W4KRL/SolarPowerMonitor/Photo_Gallery.md

# Project Photo Gallery

## Bench View
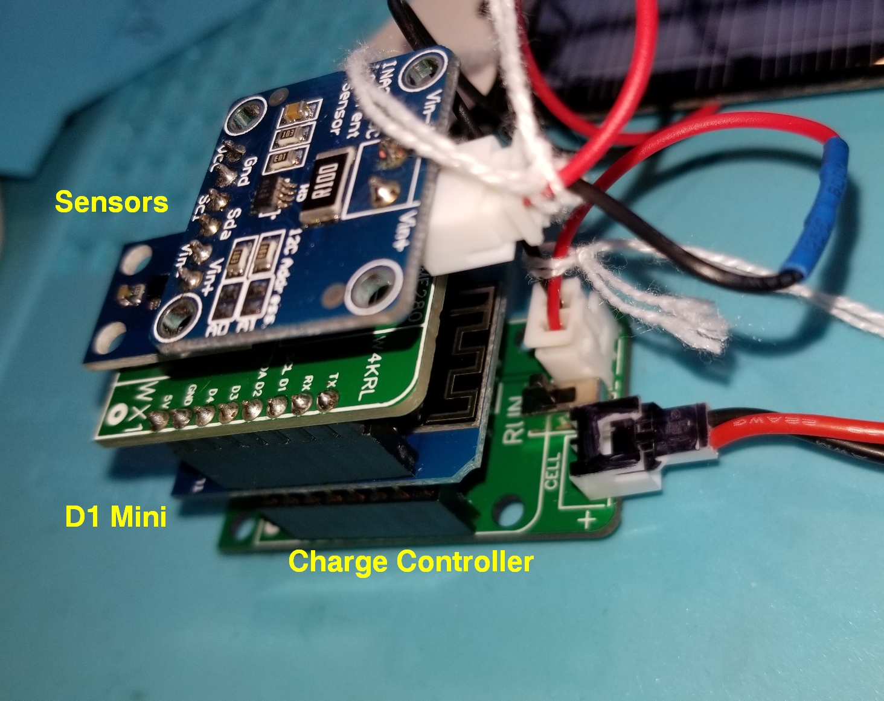
[picture p7: images/Bench_view.jpg]


### Side View with shields separated
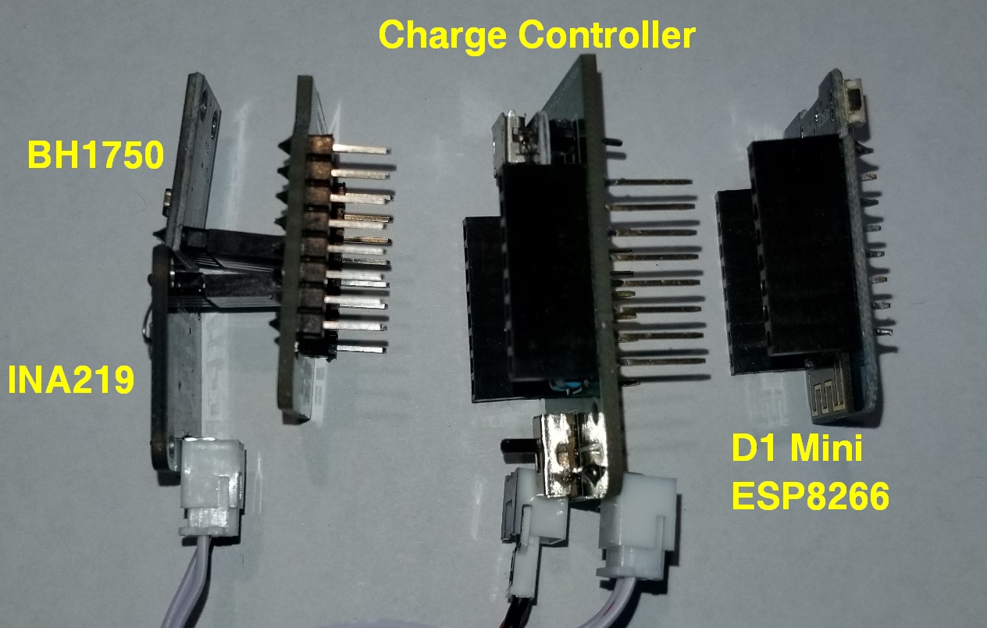
[picture p8: images/Exploded_Side_view_right.jpg]


### Top View with shields separated
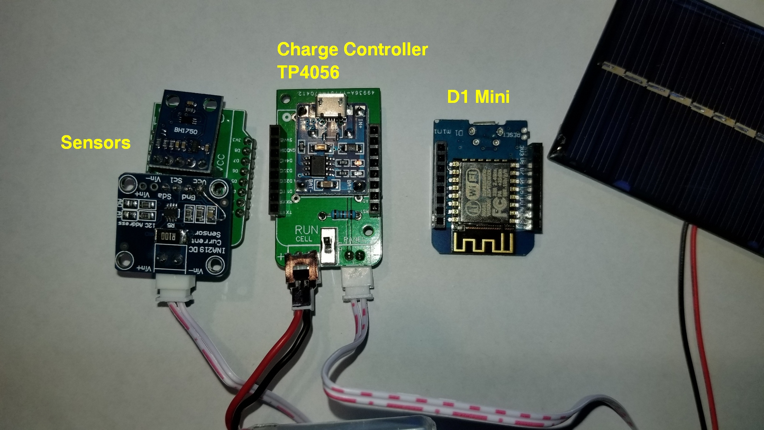
[picture p9: images/Top_view.jpg]


### Side View of assembled unit
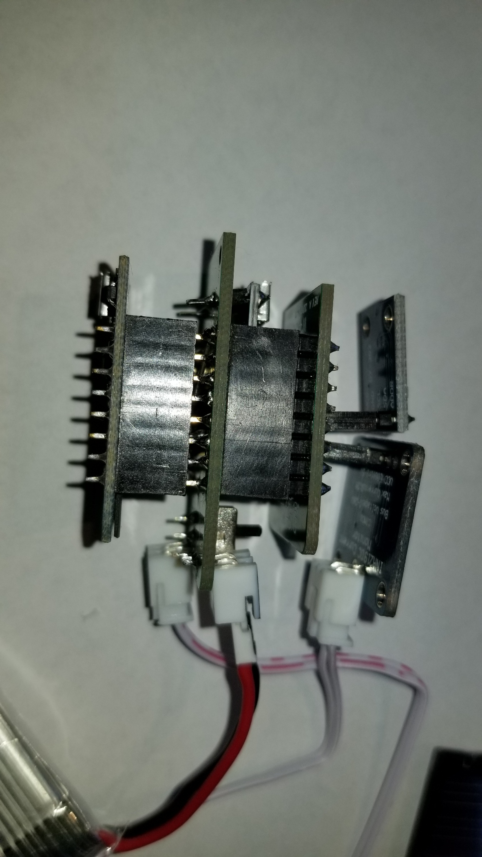
[picture p10: images/Assembled_side_view.jpg]


### Modification to charger board
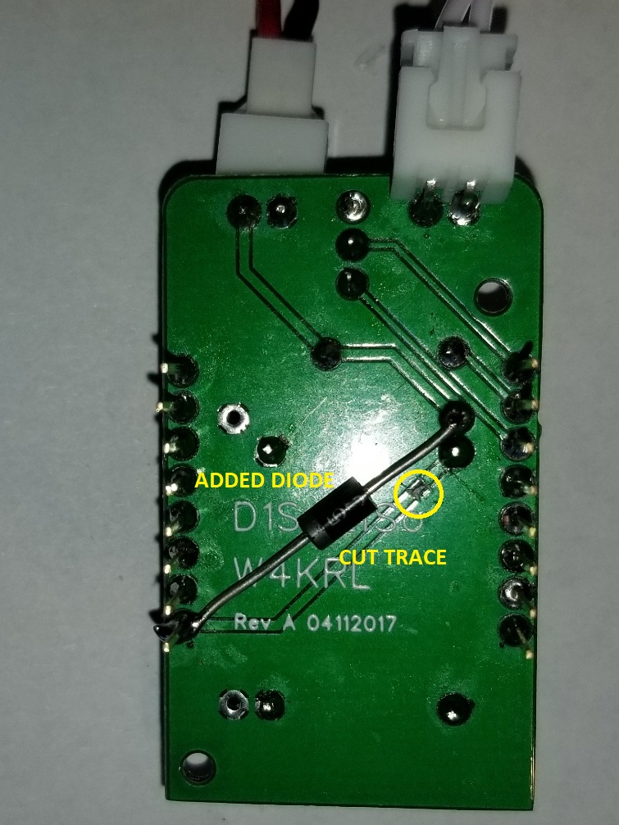
[picture p11: images/Charger_modification.jpg]


### Installation
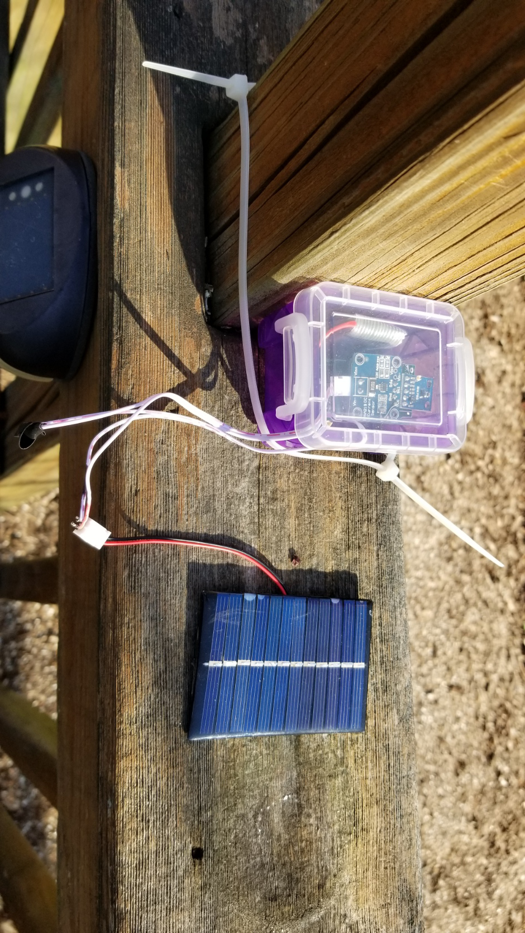
[picture p12: images/Installation.jpg]


### Unit in the rain
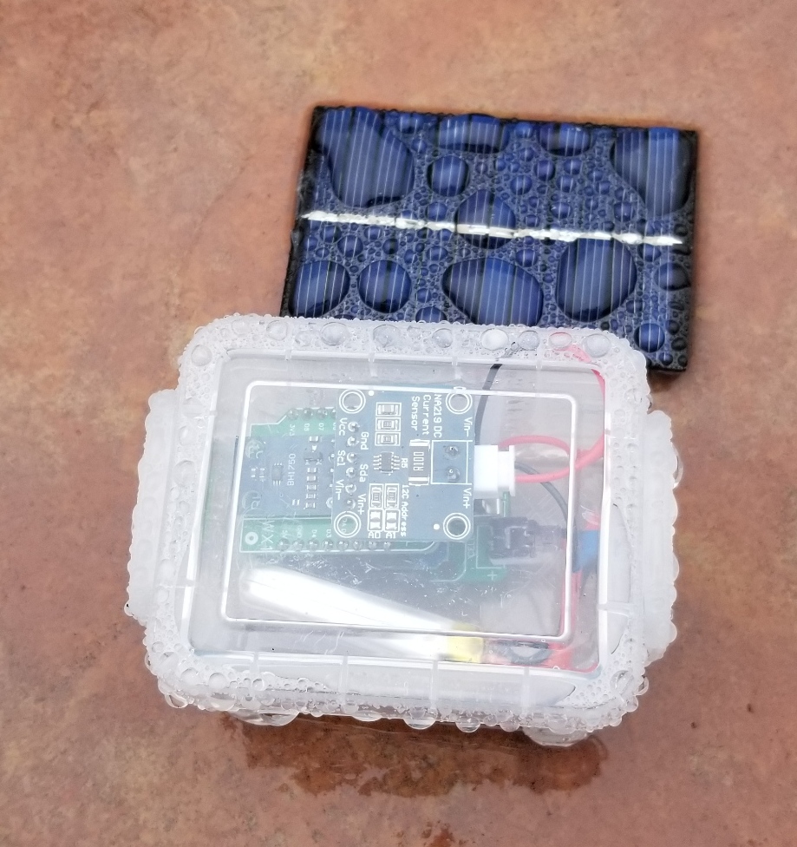
[picture p13: images/Unit-in-rain.jpg]


### Unit reconfigured to use a tripler base
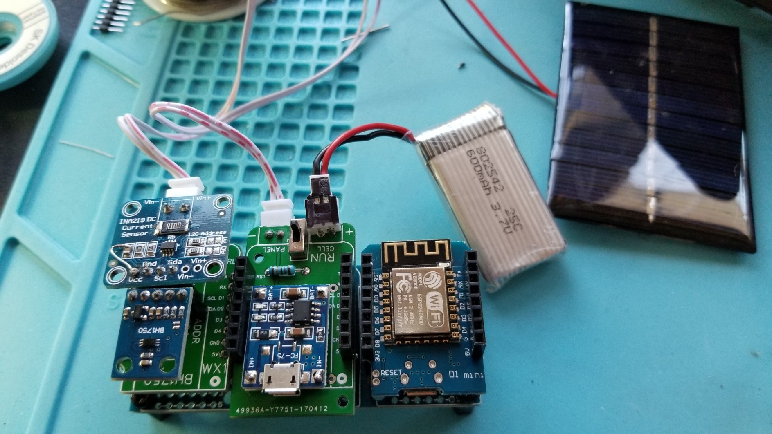
[picture p14: images/Tripler_top_view.jpg]


### Self-contained version with tripler base & solar panel mounted inside crayon box
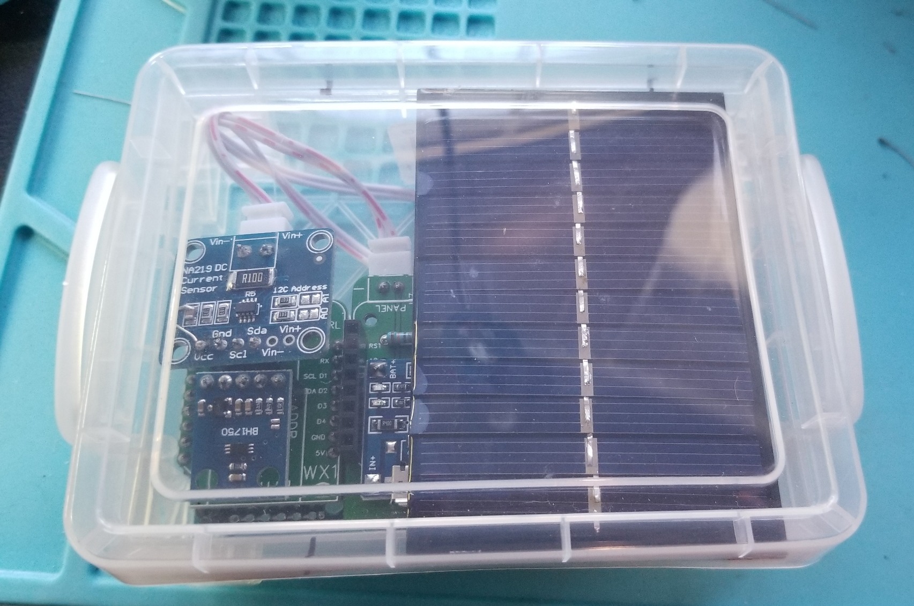
[picture p15: images/Crayon_box_unit.jpg]
