W4KRL/SolarPowerMonitor/images/Firmware_download.png

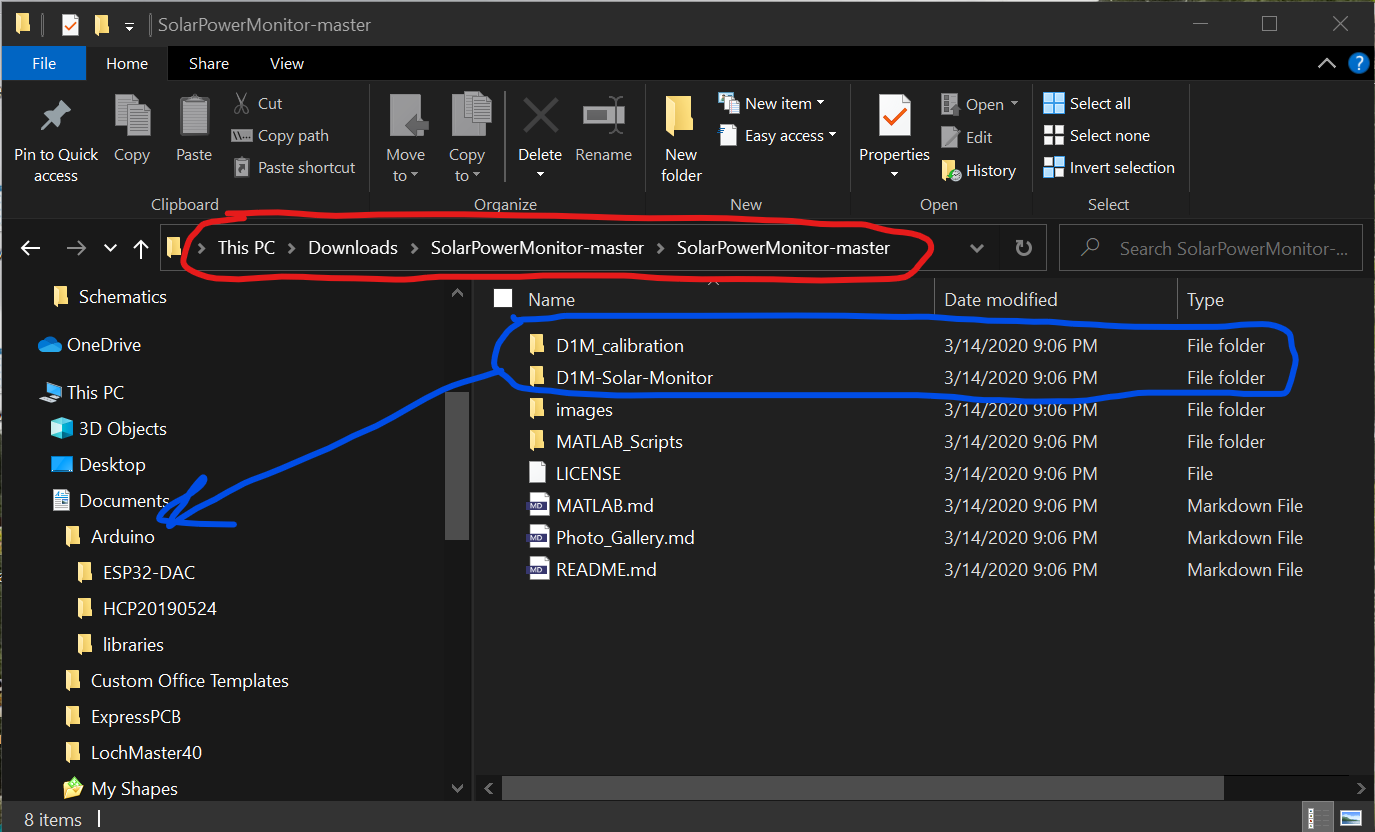
images/Firmware_download.png
