W4KRL/SolarPowerMonitor/images/SolarPowerFlow.jpg

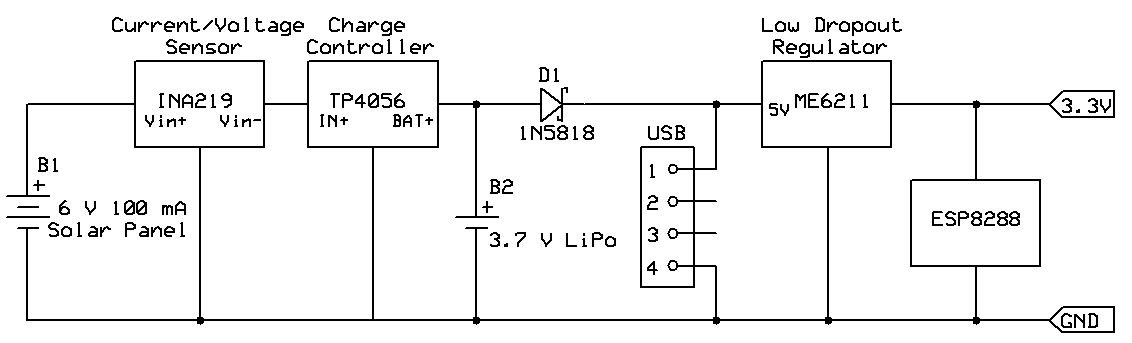
images/SolarPowerFlow.jpg
