W4KRL/SolarPowerMonitor/D1M-Solar-Monitor/D1M-Solar-Monitor.ino

/* D1M-Solar-Monitor.ino

   (C) Karl Berger, 2020 All Rights Reserved
   2020.02.24 - Adapted from D1 Mini Weather Station (Solar)
 
   Posts to ThingSpeak using the REST API

   Set serial monitor to 115,200 baud
*/
/*_____________________________________________________________________________
   Copyright 2016-2020 Berger Engineering dba IoT Kits

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
   https://w4krl.com
   _____________________________________________________________________________
*/

// 2020.02.27 - changed sleep mode to WAKE_RF_DEFAULT
// 2020.02.28 - BH1750 range set to HIGH

// ****************************************************************
// ** REMEMBER: Set switch to PROG to program and RUN to operate **
// ****************************************************************

//#include <Wire.h>                    // [builtin] I2C bus
#include <ESP8266WiFi.h>             // [builtin] ESP8266 WiFi
#include <hp_BH1750.h>               // [manager] by Stefan Armborst https://github.com/Starmbi/hp_BH1750
#include <Adafruit_INA219.h>         // [manager] https://github.com/adafruit/Adafruit_INA219

// Place your configuration file in same folder as this sketch
#include "ThingSpeak_config.h"

// *******************************************************
// *********************** GLOBALS ***********************
// *******************************************************

const char  IOT_SERVER[] = "api.thingspeak.com";  // ThingSpeak Server

// structure to hold sensor measurements/calculations
struct {
  float lightLevel;              // light intensity (lux)
  float panelVolts;              // solar panel voltage
  float panelMilliAmps;          // solar panel current
  float panelMilliWatts;         // solar panel power
  float cellVolts;               // LiPo cell voltage
  long  wifiRSSI;                // WiFi signal strength (dBm)
} sensorData;                    // declare struct

// *******************************************************
// ***************** INSTANTIATE OBJECTS *****************
// *******************************************************
hp_BH1750 myBH1750;              // light level sensor
Adafruit_INA219 myINA219;        // voltage/current sensor
WiFiClient client;               // WiFi connection

// *******************************************************
// ************************ SETUP ************************
// *******************************************************
void setup() {
  Serial.begin(115200);          // initialize the serial port
  Serial.println();              // blank lines
  Serial.println();

  initializeSensors();           // start INA219 and BH1750 sensors
  logonToRouter();               // logon to local Wi-Fi
  readSensors();                 // read data into sensorData struct
  printToSerialPort();           // display data on local serial monitor
  postToThingSpeak();            // send data to ThingSpeak
  enterSleep( SLEEP_INTERVAL );  // go to low power sleep mode
} //setup()

// *******************************************************
// ************************* LOOP ************************
// *******************************************************
void loop() {                    // nothing to do here
} // loop()

// *******************************************************
// ***************** SUPPORTING FUNCTIONS ****************
// *******************************************************

// *******************************************************
// ***************** Initialize Sensors ******************
// *******************************************************
void initializeSensors() {
  // "TO_GROUND" used for stock BH1750 (GY-302) sensor
  bool avail = myBH1750.begin(BH1750_TO_GROUND);  // init with address pin connected to ground
  // result (bool) will be be "false" if no sensor found
  myBH1750.calibrateTiming();

  myINA219.begin();
  myINA219.setCalibration_16V_400mA();  // set to maximum sensitivity
} // initializeSensors()

// *******************************************************
// ********* Read sensors into sensorData struct *********
// *******************************************************
void readSensors() {
  // read light level in lux
  myBH1750.start(BH1750_QUALITY_HIGH, 31);        // max 121,557 lux, resolution 1.85
  sensorData.lightLevel = myBH1750.getLux();      // get light measurement (blocking)

  // read analog voltage from the Analog to Digital Converter
  // on D1 Mini this is 0 - 1023 for voltages 0 to 3.2V
  // the Solar Monitor has an external resistor to extend the range to 5.0 Volts
  // a fudgeFactor corrects for voltage divider component variation
  // as measured by the user in the calbration step
  float fudgeFactor = dmmVoltage / adcVoltage;
  sensorData.cellVolts = 5.0 * analogRead(A0) * fudgeFactor / 1023.0;

  // read solar panel output
  sensorData.panelVolts      = myINA219.getBusVoltage_V();
  sensorData.panelMilliAmps  = myINA219.getCurrent_mA();
  sensorData.panelMilliWatts = myINA219.getPower_mW();

  // read the Wi-Fi signal strength
  sensorData.wifiRSSI = WiFi.RSSI();

} // readSensors()

// *******************************************************
// ************ Print data to the serial port ************
// *******************************************************
void printToSerialPort() {
  // '\t' is the C++ escape sequence for tab
  // header line
  Serial.println("\n\tlux\tVp\tmA\tmW\tVc\tdBm");
  // data line
  Serial.print("Data\t");
  Serial.print(sensorData.lightLevel, 0);
  Serial.print("\t");
  Serial.print(sensorData.panelVolts, 2);
  Serial.print("\t");
  Serial.print(sensorData.panelMilliAmps, 2);
  Serial.print("\t");
  Serial.print(sensorData.panelMilliWatts, 2);
  Serial.print("\t");
  Serial.print(sensorData.cellVolts, 2);
  Serial.print("\t");
  Serial.println(sensorData.wifiRSSI);
  Serial.println("----------------------------------------------------------------------------");
} // printToSerialPort()

// *******************************************************
// ************** Logon to your Wi-Fi router *************
// *******************************************************
void logonToRouter() {
  WiFi.persistent(false);    // prevent it from writing logon to flash memory
  WiFi.mode(WIFI_OFF);
  delay(100);
  int count = 0;
  WiFi.mode(WIFI_STA);
  WiFi.forceSleepWake();
  WiFi.begin( WIFI_SSID, WIFI_PASSWORD );
  while ( WiFi.status() != WL_CONNECTED ) {
    count++;
    // give up if more than 100 tries (10 seconds)
    if ( count > 100) {
      Serial.print("\nWiFi failed. ");
      enterSleep( SLEEP_INTERVAL );   // retry after sleep
      // ****************************************************
      // ** PROCESSING ENDS HERE IF IT FAILS TO CONNECT!!! **
      // ****************************************************
    }
    delay( 500 );                     // ms delay between reports
    Serial.print(".");
  } // loop while not connected
  // WiFi is sucesfully connected
  Serial.print("\nWiFi connected to IP: ");
  Serial.println(WiFi.localIP().toString());
} // logonToRouter()

// *******************************************************
// ********** Post data to ThingSpeak ********************
// *******************************************************
void postToThingSpeak() {
  // assemble and post the data
  if ( client.connect(IOT_SERVER, 80) == true ) {
    Serial.print("ThingSpeak Server connected. ");
    // declare dataString as a String and initialize with the API_WRITE_KEY
    String dataString = API_WRITE_KEY;
    // cocatenate each field onto the end of dataString
    dataString += "&field1=" + String(sensorData.lightLevel);
    dataString += "&field2=" + String(sensorData.panelVolts);
    dataString += "&field3=" + String(sensorData.panelMilliAmps);
    dataString += "&field4=" + String(sensorData.panelMilliWatts);
    dataString += "&field5=" + String(sensorData.cellVolts);
    dataString += "&field6=" + String(sensorData.wifiRSSI);
    //    dataString += "&field7=" + String();
    //    dataString += "&field8=" + String();
    //    dataString += "&status=" + unitStatus;
    //    Serial.println(unitStatus);   // show status on local serial monitor

    // find the number of characters in dataString
    String dataStringLength = String(dataString.length());

    // post the data to ThingSpeak
    client.println("POST /update HTTP/1.1");
    client.println("Host: api.thingspeak.com");
    client.println("Connection: close");
    client.println("X-THINGSPEAKAPIKEY: " + API_WRITE_KEY);
    client.println("Content-Type: application/x-www-form-urlencoded");
    client.println("Content-Length: " + dataStringLength);
    client.println("");
    client.print(dataString);

    Serial.print("ThingSpeak data sent. ");
  }
  //TODO: remove delay
  delay(500);
  client.stop();
  Serial.println("ThingSpeak disconnected.");
} // postToThingSpeak()

// *******************************************************
// ********************* Enter Sleep *********************
// *******************************************************
void enterSleep(long sleep) {
  WiFi.disconnect( true );
  delay(1);
  // sleep is in seconds
  Serial.print("Entering deep sleep for ");
  Serial.print( sleep );
  Serial.println(" seconds.");
  // WAKE_RF_DEFAULT wakes with WiFi radio ON
  ESP.deepSleep(sleep * 1000000L, WAKE_RF_DEFAULT);
} // enterSleep()

// *******************************************************
// *********************** END ***************************
// *******************************************************
