W4KRL/SolarPowerMonitor/(commit log)

2020-02-27 Create MATLAB_PowerLight_Overlay
    MATLAB code to plot solar panel power overlayed with light intensity. Plotted against time.
2020-02-27 Create MATLAB_Power_Light_Correlation
    MATLAB script to show correlation between solar panel power output and light intensity
2020-02-27 Create D1M-Solar-Monitor.ino
    Arduino Sketch for Solar Monitor
2020-02-28 Revised schematic
2020-03-12 Create Current_Values
